ut-robotics/picr21-team-sauna-madis/(list of files, drawings)

Other design files:
comp.PcbLib
comp.SchLib
PCB1.PcbDoc
picr21-team-sauna-madis-mainboard.PrjPcb
saunamadis.SchDoc
