ut-robotics/picr21-team-sauna-madis/(threads)

Thread 1 (2021-09-22):

[Mechanics] - Motor mounting hole dimensions

maidlam, 2021-09-22:
1. Currently, the thrower motor can only be attached with 2 bolts.

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

The distances between the holes are 16 mm in one axis and 19 mm in the other axis.
**Bolt holes** in [https://hobbyking.com/en_us/ntm-prop-drive-28-26-1000kv-235w.html?___store=en_us](https://hobbyking.com/en_us/ntm-prop-drive-28-26-1000kv-235w.html?___store=en_us)

2. It would be better if the distance to the thrower motor was defined by the center of the motor - changing the current dimension of 9,5 mm causes the center of the motor to move out of place.

KasperKaljuste, 2021-09-27:
Fixed the dimensions.

maidlam, 2021-09-29:
The sketch is not fully defined. Set the distances to the blue circles and add an axis through the center of the bigger circle so that the two axis of the holes are perpendicular to each other.
The 18.082 dimension feels weird there.
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

KasperKaljuste, 2021-09-30:
Should be solved.

Akustav, 2021-10-02:
Holes are now OK

Closed 2021-10-02.

Thread 2 (2021-09-22):

[Mechanics] - Missing attachement pieces for C-ramps

maidlam, 2021-09-22:
The C-ramps are currently floating.
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

What are you planning to use to attach these?

KasperKaljuste, 2021-09-27:
Added spacers to attact C-ramps.

maidlam, 2021-09-29:
1. The dimensions of the spacers are wrong. The length from side to side is 5,5 mm.
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

2. If you are planning to use female-female spacers, then the inside of the spacer needs to be threaded and the holes in the walls should be 3mm in diameter.

KasperKaljuste, 2021-09-30:
Should be solved now.

maidlam, 2021-10-01:
Spacers have the wrong dimension. Should be 5,5mm from edge to edge, or 2,75mm from center.
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

KasperKaljuste, 2021-10-02:
My bad, fixed it.

Akustav, 2021-10-02:
Seems fine now.

Closed 2021-10-02.

Thread 3 (2021-09-22):

[Mechanics] - Inside corner cutouts made weird

maidlam, 2021-09-22:
The current method - defining the cutout hole center with distances - seems to contain too much manual work.
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

A better method would be make the cutout in the sketch, where the hole for the cutout is coincident with the corner.
[https://digilabor.ut.ee/index.php/Basketball_robot_mechanics_design#Inside_sharp_corners](https://digilabor.ut.ee/index.php/Basketball_robot_mechanics_design#Inside_sharp_corners)

KasperKaljuste, 2021-09-27:
I used this addin to make the inside corner cutouts: https://github.com/DVE2000/Dogbone

maidlam, 2021-09-29:
Resolved

Closed 2021-09-29.

Thread 4 (2021-09-22):

[Mechanics] - Missing bolt holes

maidlam, 2021-09-22:
There are a few missing bolt holes in one of the walls.
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

KasperKaljuste, 2021-09-27:
Added missing bolt holes.

maidlam, 2021-09-29:
Resolved

Closed 2021-09-29.

Thread 5 (2021-09-22):

[Mechanics] - Add robot chassis to assembly

maidlam, 2021-09-22:
Adding the robot chassis to the assembly can give a better visual, if the components are physically mountable to the robot, and help gauge the distance between the thrower motor and the ground.

KasperKaljuste, 2021-09-27:
Added the bottom part of the chassis to thrower. Are other parts necessary?

maidlam, 2021-09-29:
1. Ideally, the height of the bottom plate should be set as it is in real life. Then you can then check how high the thrower motor is from the floor (to see if a ball will touch the motor). You could have the XY plane act as the floor in the model.

2. You should add motors and motor mounts. I think the thrower walls might not interfere with the motors, but good to check.
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

3. Add a rectangle to the thrower motor to visualize the wires coming from it (something like picture below). Verify the angle on your actual motor.
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

KasperKaljuste, 2021-10-01:
Added motor mount, motor, visualized wires.

Akustav, 2021-10-02:
Hey! Seems like the motor sits too low now. Comparison with ball in picture:
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

KasperKaljuste, 2021-10-04:
The motors edge is now 35mm from the ground.

KasperKaljuste, 2021-10-07:
Raised the motor to 53mm.

Thread 6 (2021-10-02):

[Mechanics] - internal ramp radius too small

Akustav, 2021-10-02:
I think the space for the ball between the ramp and motor is too small. It should compress the ball in the range of 5-10 mm. This is too much:
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

KasperKaljuste, 2021-10-04:
Made the radius 35mm

Akustav, 2021-10-06:
Seems OK.

Closed 2021-10-06.

Thread 9 (2021-12-03):

[Mechanics] - use countersunk screws?

Akustav, 2021-12-03:
This depends on your robot design but if you do not plan to cover the wheels and they are on the outside of the robot the spinning screw heads might damage the field or opponent.

If you plan to cover the wheel or if the wheel sits more inside the robot this is not an issue.

Closed 2022-01-05.

Thread 18 (2022-01-15):

Motor driver bulk capacitors

ReikoR, 2022-01-15:
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

220 uF capacitors rated 25V+ don't really exist.

Highest capacitance available from [Mouser](https://www.mouser.ee/c/passive-components/capacitors/mlccs/multilayer-ceramic-capacitors-mlcc-smd-smt/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) right now is 33 uF. But those are quite expensive.

In the lab we have 10 uF 1206 capacitors. I recommend using about 4 - 5 (or more if there's room) per driver.

For the shortest and widest connection I would recommend putting capacitors on bottom layer below the driver and connecting them with multiple vias. All high current connections (driver GND, VM and outputs) outputs should be made with wider tracks or polygons.

Something like this:
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

Closed 2022-02-24.

Thread 19 (2022-01-15):

Use wider tracks or polygons and multiple vias for high currents

ReikoR, 2022-01-15:
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

Copper should be wider to carry all the current and multiple vias should be used when changing layer.

Internal ground layers should be connected with multiple vias to GND power pad:
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

Most of the return current should be on internal layers. It's not really needed to have big ground polygons on outer layers.

Saturn PCB Design Toolkit is a good program to calculate different properties:
https://saturnpcb.com/saturn-pcb-toolkit/

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

ReikoR, 2022-02-24:
1. BAT- is not connected to PGND
  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

2. Use wider track/polygon between battery plus and MOSFET.
  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

Closed 2022-02-24.

Thread 20 (2022-01-15):

Put ground vias near pads

ReikoR, 2022-01-15:
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

Vias should be near component ground pads. It is also fine to put them inside pads when hand soldering the components. Vias inside pads provide the lowest inductance.

Internal ground layers should be used for return currents, because there are no big gaps in the copper, that would cause the electromagnetic fields to spread out and cause signal integrity issues.

ReikoR, 2022-02-24:
1. Some missing vias
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

2. In general it's better to put decoupling capacitors as close as possible to components and then put vias close or inside capacitor pads. Capacitor should be closer to the component than vias. There is a current loop that charges the capacitor and current loop that sources the current from capacitor to the component. Short connections help to reduce the inductance.
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

Closed 2022-02-24.

Thread 21 (2022-01-15):

Avoid crossing the isolation gap

ReikoR, 2022-01-15:
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

All the tracks should be kept above the ground layer copper on the respective side. Isolation gap should also be made wider if possible.

ReikoR, 2022-02-24:
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

All tracks should be kept above the ground plane/polygon to prevent electric fields between tracks and ground from spreading out.

Closed 2022-02-24.

Thread 22 (2022-01-15):

Improve USB signal routing

ReikoR, 2022-01-15:
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

USB data signals are a differential pair and should be kept symmetrical if possible. Also using vias can cause noise from reflections when vias have different impedance compared to the tracks. In general it is better to avoid using vias.

D- and D+ can be swapped on the ESD protection.

Something like this:
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

ReikoR, 2022-02-24:
Differential pair directive symbol needs to be connected to a wire on a schematic to work. And only 1 diff pair directive symbol should be connected per wire.

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

USB signals should have 90 ohm differential impedance.

JLCPCB has impedance calculator:
https://cart.jlcpcb.com/impedanceCalculation

Trace space of 0.2 mm (8 mil) and trace width of 0.26 mm (10.26 mil) should work fine.
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

This video is probably useful:
https://www.youtube.com/watch?v=vkfnMtRUCOM

Closed 2022-02-24.

Thread 23 (2022-01-15):

Board outline should be added to Mechanical (M1) layer

ReikoR, 2022-01-15:
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

Board outline can be added by drawing a rectangle or an easier option is to use Design -> Board Shape -> Create Primitives from Board Shape.

Component libraries should be changed so that any 3D bodies are moved from M1 layer to M13 layer.

ReikoR, 2022-02-24:
Motor drivers still have a small 3D body on M1 layer:

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

Closed 2022-02-24.

Thread 29 (2022-01-19):

Use wider resolutions

ReikoR, 2022-01-19:
https://github.com/ut-robotics/picr21-team-sauna-madis/blob/4c6d1c92842338af8816641a25f335507717bdcf/saun/image.py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

Wider resolutions have wider field of view.
Also use higher framerate.

For example 848x480 @ 60 FPS

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
https://www.intelrealsense.com/wp-content/uploads/2020/06/Intel-RealSense-D400-Series-Datasheet-June-2020.pdf

`if device_product_line == 'L500':` is not needed, since you don't have this camera.

ReikoR, 2022-01-22:
https://github.com/ut-robotics/picr21-team-sauna-madis/blob/1f4b77ebae64bb29882fd5f36271e09f96811f76/saun/image.py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

Only framerate has been increased. Horizontal resolution is the same.

Closed 2022-01-24.

Thread 30 (2022-01-19):

Align depth frame with color frame.

ReikoR, 2022-01-19:
https://github.com/ut-robotics/picr21-team-sauna-madis/blob/4c6d1c92842338af8816641a25f335507717bdcf/saun/image.py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

Since the depth and colors sensors are physically apart, the depth and color frames need to be aligned to get correct depth results.

Alignment example:
https://github.com/IntelRealSense/librealsense/blob/master/wrappers/python/examples/align-depth2color.py

ReikoR, 2022-01-22:
Have you tested the code?

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

Closed 2022-01-24.

Thread 31 (2022-01-21):

Missing bolt holes for components attached to plates

maidlam, 2022-01-21:
The components are missing holes so they can be attached to the top and bottom plates. The plates will also need corresponding holes.

KasperKaljuste, 2022-01-23:
Thought I would add them manually after.

maidlam, 2022-01-23:
Right now I don't think the pieces will hold.
For the components made out of 4,8mm polycarbonate, the holes should be in the components, not the tenons.
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

Holes also missing for:
- PC
- Mainboard
- DC-DC converter
- Camera mount sidewalls to attach to top plate

Thread 32 (2022-01-21):

Missing NUC power adapter socket cutout

maidlam, 2022-01-21:
The cutout to attach the NUC power adapter socket is missing.

KasperKaljuste, 2022-01-23:
Added.

Akustav, 2022-01-23:
Is the current placement kind of inconvenient when wanting to plug the NUC in? It could be moved forward so the camera does not block it.
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

KasperKaljuste, 2022-01-23:
Fixed.

Closed 2022-01-23.

Thread 33 (2022-01-21):

Add mainboard and d-dc converter to assembly

maidlam, 2022-01-21:
Add the mainboard and dc-dc converter to the robot.
Add holes to mount them.

KasperKaljuste, 2022-01-23:
I'm not sure where exactly to place them, thought I would add the holes manually to make the cable managment as good as possible.

Akustav, 2022-01-23:
You should know approximately where what cables will be attached to the mainboard. Then you can consider cutouts in the chassis to complement the whole wiring effort

Thread 34 (2022-01-21):

Camera holder could be made more rigid

maidlam, 2022-01-21:
The camera holder could be made more rigid.

Bolts may not always be strong. When the adjustable camera mount is accidentally moved, the angle change can cause issues with camera settings and distance measurements. Recovering the correct angle is going to require a lot of time as well.

For exmaple, having the mounting plate be attached rigidly (using tenons and bolts), and for the plate to have two exact holes for the camera attachment bolts would help remove those issues.

A crude example of attaching the mounting plate.
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

KasperKaljuste, 2022-01-23:
Changed.

Closed 2022-01-23.

Thread 35 (2022-01-21):

What stops balls going into the chassis?

maidlam, 2022-01-21:
You should add something around the side to stop balls getting into the chassis.

KasperKaljuste, 2022-01-23:
Added ribs to the bottom plate. The rear of the robot should be okay as the batteries block the way.

maidlam, 2022-01-23:
The design should work if the spacers were made taller (using 20mm spacers maybe).
Right now the distance between the rib and top plate is 41,6mm, a ball can get in there.
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

KasperKaljuste, 2022-01-23:
Fixed.

Closed 2022-01-23.

Thread 36 (2022-01-21):

Top plate blocks some FOV

maidlam, 2022-01-21:
The camera also has hoirzontal FOV (69 degrees)

The marked parts of the top plate might get in the way of the image, so there should be cutouts in the plate there.
Add a horizontal angle to the FOV to see parts that can get in the way.

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

KasperKaljuste, 2022-01-23:
I would like the ball to be seen when it is about to enter the thrower, added cutouts to top plate.

Closed 2022-01-23.

Thread 37 (2022-01-21):

Thrower could be moved inward for better ball centering

maidlam, 2022-01-21:
The thrower could be moved inward, so the ball has more distance to align itself before hitting the thrower motor.

Currently, the ball can be pulled in from the sides and go through the thrower at an angle.
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

KasperKaljuste, 2022-01-23:
Moved it 10mm inward and made the bottom plate guiding angle smaller.

Closed 2022-01-23.

Thread 38 (2022-01-22):

State handlers are called on each iteration

ReikoR, 2022-01-22:
https://github.com/ut-robotics/picr21-team-sauna-madis/blob/1f4b77ebae64bb29882fd5f36271e09f96811f76/saun/main.py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

It would probably be better to have enum for game state and call state handlers based on the enum value.

Other option is to have some variable for active state handler:
```python
active_state_handler = find_ball;

while move_style == MoveStyle.AUTO:
    active_state_handler()
```

Also `get_ball_cord` is called multiple times during each iteration. This can't be good for performance.

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

ReikoR, 2022-01-24:
https://github.com/ut-robotics/picr21-team-sauna-madis/blob/cd3e4fc09a54c9e9432e90c289784c3d13cb4e2a/saun/main.py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

`get_ball_cord`/`get_basket_cord`/`get_ballNbasket_cord`  should be called only once per game state iteration as calling it will cause to wait for new camera frames and different frames contain different information.

uschults, 2022-01-25:
It is called once per while loop, which is one game state iteration. The first get_ball_cord() is to make sure the ball is still in view and can go into the while loop to rotate around the ball.

Akustav, 2022-01-25:
I think what Reiko tries to say is that all the check methods use this method under the hood:

https://github.com/ut-robotics/picr21-team-sauna-madis/blob/a80c9164e964e816dcf8a4658698719917ffa470/saun/image.py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

This method executes:
https://github.com/ut-robotics/picr21-team-sauna-madis/blob/a80c9164e964e816dcf8a4658698719917ffa470/saun/image.py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

And as the name implies, it waits for a new frame. So if you use get_ball_cord() and get_ballNbasket_cord(), it uses 3 separate framers, so instead of 60 fps, you get 20. You should fetch the frame once, and then process the data of that frame, not get a fresh frame every time.

uschults, 2022-01-25:
now uses one frame for both.

Closed 2022-01-25.

Thread 44 (2022-01-25):

Resolution data should be held in Image

Akustav, 2022-01-25:
Currently the frame center point is held inside main.py while the resolution is inside image.py. You should unify where resolution data is kept and since it is more connected to the Image, it should be inside image.py, not main.py.

https://github.com/ut-robotics/picr21-team-sauna-madis/blob/a80c9164e964e816dcf8a4658698719917ffa470/saun/main.py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

uschults, 2022-01-25:
it is needed for game logic, not for image or image processing.

Akustav, 2022-01-25:
Then why not hold frame resolution inside Image and calculate camera_x_mid as follows` camera_x_mid = image.x_resolution / 2`

uschults, 2022-01-25:
yes, done

Closed 2022-01-25.

Thread 49 (2022-02-24):

Remove dead copper

ReikoR, 2022-02-24:
Copper that is not connected to anything can couple to signals and cause crosstalk in other signals.

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

In polygon properties it's possible to select **Remove Dead Copper**:
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

It's probably ok to use ground polygon pour on outer layers, but unconnected copper should be removed.

More information:
https://resources.altium.com/p/copper-pour-and-stitching-do-you-need-them-pcb-layout
https://www.youtube.com/watch?v=y4REmZlE7Jg&t=2417s

Closed 2022-02-24.
