ut-robotics/picr21-team-sauna-madis/saun/ps4controllertest.py

from pyPS4Controller.controller import Controller
    
    
class MyController(Controller):

    def __init__(self, **kwargs):
        Controller.__init__(self, **kwargs)

    def on_x_press(self):
       print("Hello world")

    def on_x_release(self):
       print("Goodbye world")

controller = MyController(interface="/dev/input/js0", connecting_using_ds4drv=False)
# you can start listening before controller is paired, as long as you pair it within the timeout window
controller.listen(timeout=60)
