ut-robotics/picr21-team-sauna-madis/(commit log)

2021-09-30 Get image from camera, and set thresholds
2021-10-29 startRobot threadide lisamine
2021-11-16 pid test
2021-11-16 ilma threadimiseta
2022-01-20 camera settings
2022-01-25 ??Enum and global issue fixed?? !!NEEDS TESTING!!
    [imageProcess.py, main.py, movement.py, var.py]
2022-01-25 ??Enum and global issue fixed?? !!NEEDS TESTING!! small fix added to last push
    [main.py]
2022-01-25 frame fix
2022-02-21 PCB ja SCH parandused
    [PCB1.PcbDoc, comp.PcbLib, picr21-team-sauna-madis-mainboard.PrjPcb, saunamadis.SchDoc]
2022-02-24 fix: PCB ja skeemi parandused
    [PCB1.PcbDoc, comp.PcbLib, saunamadis.SchDoc]
2022-02-24 fix: remove dead copper
    [PCB1.PcbDoc]
